liulizhi1031/MyKeyBoardMini/README.md

# **My KeyBoard (Mini)**

呃，这个键盘可能没那么好用。。。

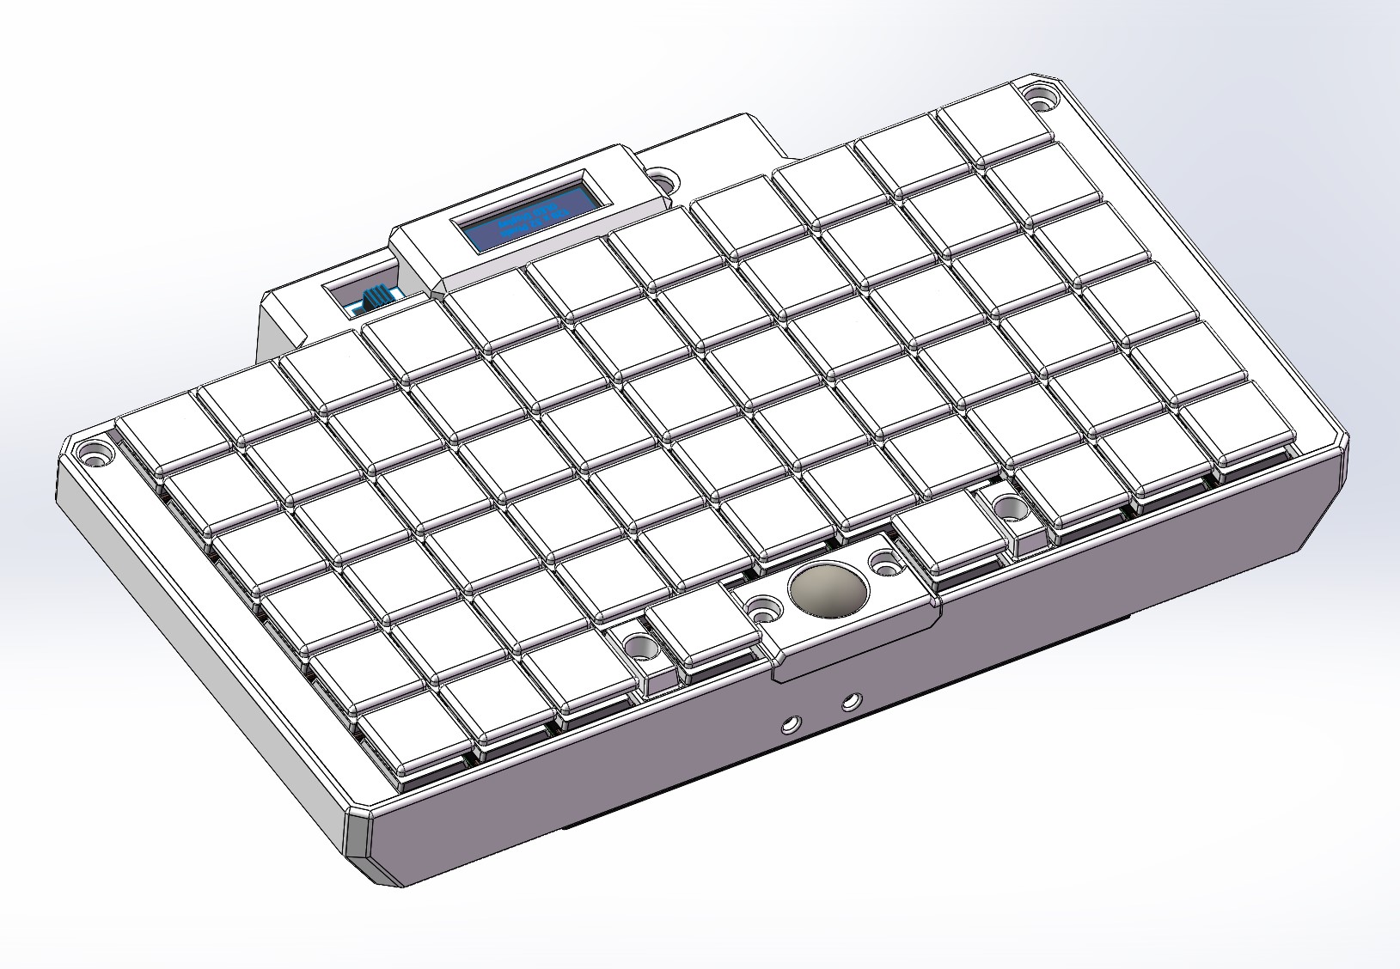
[picture p1: doc/img/3dmodel1.jpg]
3dmodel1


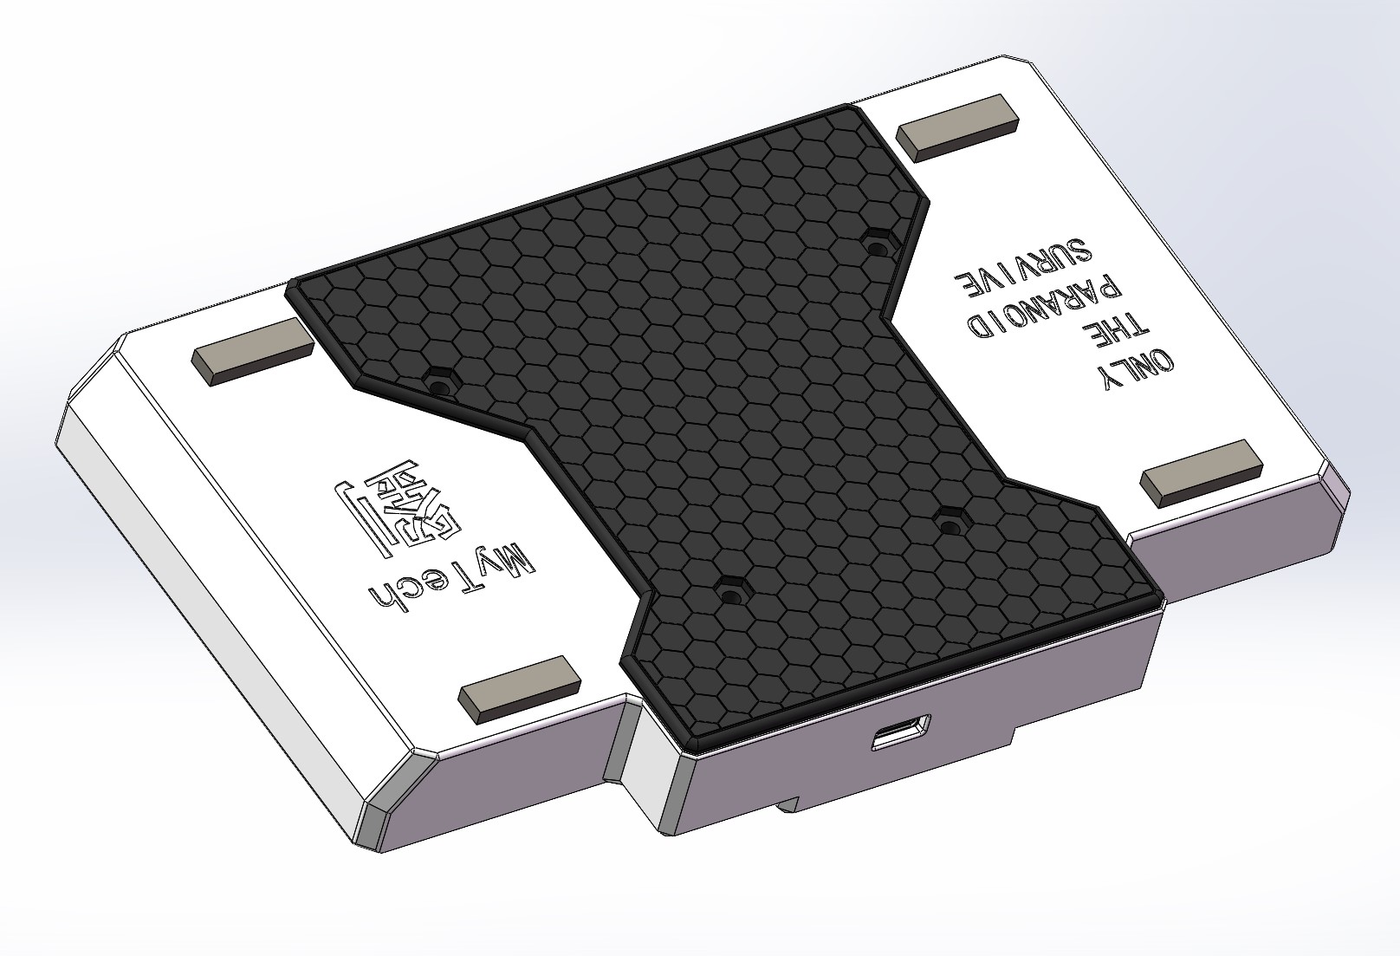
[picture p2: doc/img/3dmodel2.jpg]
3dmodel1
