liulizhi1031/MyKeyBoardMini/doc/doc_design/KeyMapDesign.xlsx

Esc | / ? | ; : | " | [ { | ] } | \ | | - _ | = + | Delete | BackSpace
` ~ | 1 ! | 2 @ | 3 # | 4 $ | 5 % | 6 ^ | 7 & | 8 * | 9 ( | 0 )
Tap | Q (F1) | W (F2) | E (F3) | R (F4) | T (F5) | Y (F6) | U (F7) | I (F8) | O (F9) | P (F10)
CapsLock | A (F11) | S (F12) | D | F | G | H | J | K | L | Enter
Shift | Z | X | C | V | B | N | M (Win) | , < | . > | Shift
Ctrl | Alt | Space |  | ML |  | MR |  | Fn | Alt | Ctrl
