liulizhi1031/MyKeyBoardMini/3dModel/header-2-54/Header Pins/header.SLDASM

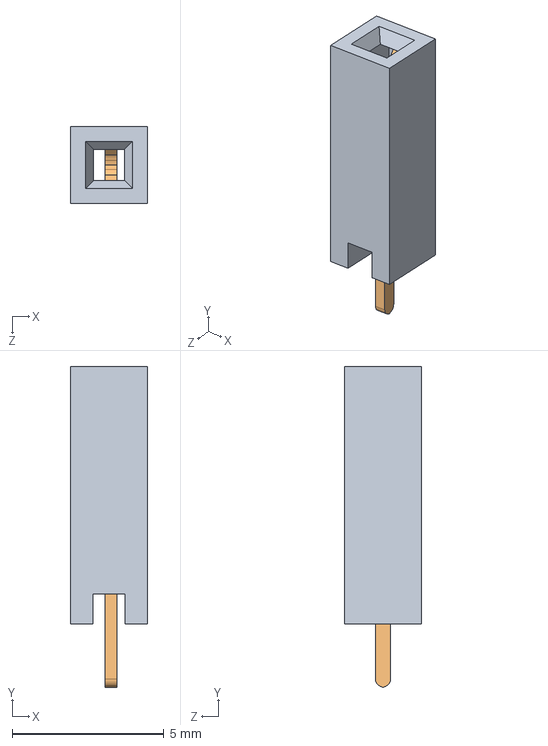
[picture p3: CAD file, 2023-10-30]
3dModel/header-2-54/Header Pins/header.SLDASM
2.54 x 10.6 x 2.54 mm
header
pin
