liulizhi1031/MyKeyBoardMini/3dModel/header-2-54/Header Pins/Header_4.SLDASM

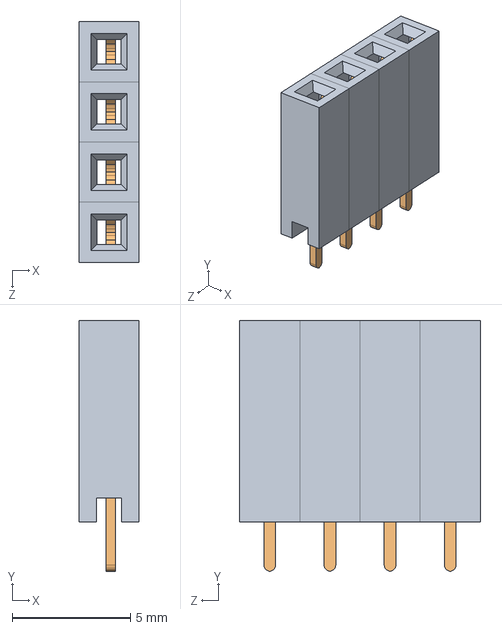
[picture p4: CAD file, 2023-10-30]
3dModel/header-2-54/Header Pins/Header_4.SLDASM
2.54 x 10.6 x 10.2 mm
header x 4
pin x 4
