liulizhi1031/MyKeyBoardMini/3dModel/KEYBOARD.SLDASM

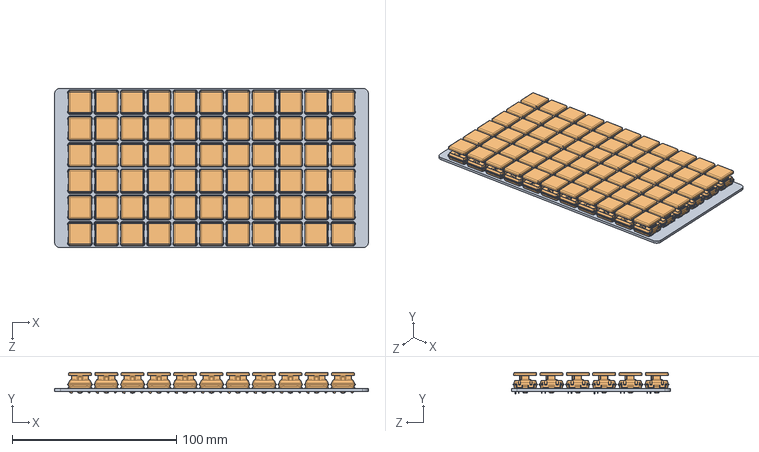
[picture p5: CAD file, 2023-06-11]
3dModel/KEYBOARD.SLDASM
191.0 x 13.0 x 97.0 mm
keyboardbase
KailhLowProfileSwitch x 66
