liulizhi1031/MyKeyBoardMini/3dModel/KAILH_1350/Kailh1350.SLDPRT

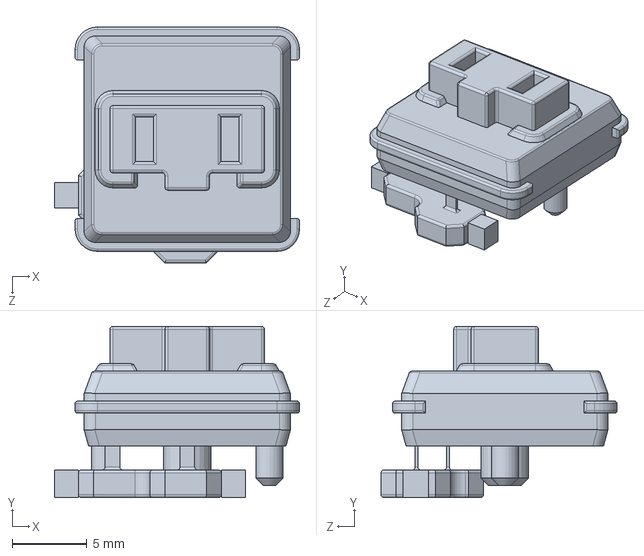
[picture p6: CAD file, 2023-10-30]
3dModel/KAILH_1350/Kailh1350.SLDPRT
16.4 x 11.5 x 15.8 mm
