liulizhi1031/MyKeyBoardMini/3dModel/底盖.SLDPRT

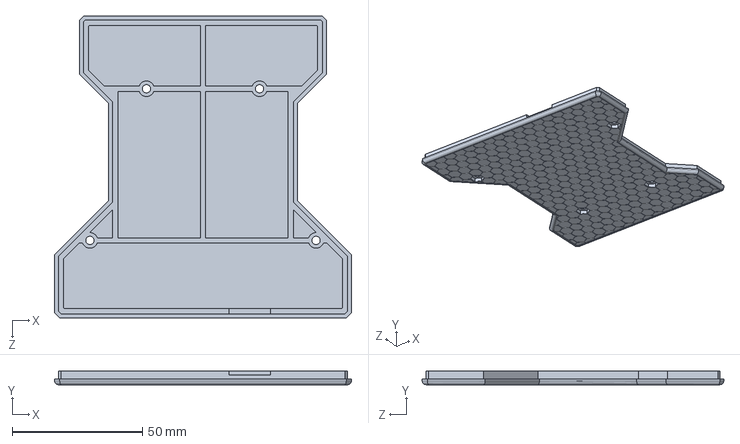
[picture p7: CAD file, 2023-11-14]
3dModel/底盖.SLDPRT
114.0 x 5.20 x 115.8 mm
