liulizhi1031/MyKeyBoardMini/3dModel/header-2-54/Header Pins/pin.sldprt

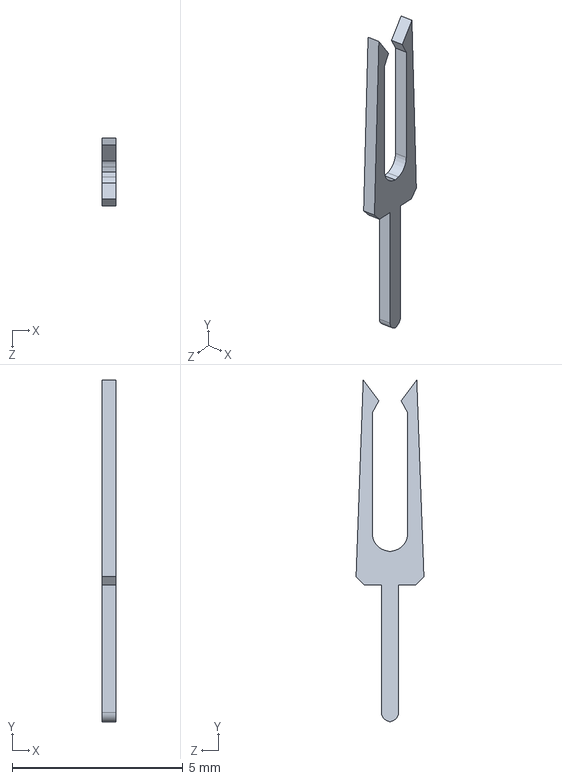
[picture p8: CAD file, 2023-10-30]
3dModel/header-2-54/Header Pins/pin.sldprt
0.4 x 10.0 x 1.99 mm
