liulizhi1031/MyKeyBoardMini/3dModel/轨迹球盖.SLDPRT

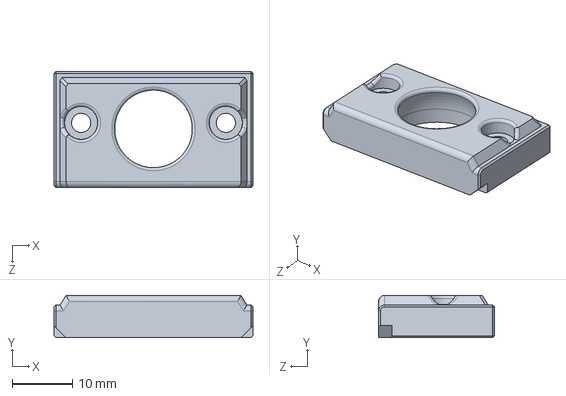
[picture p9: CAD file, 2023-11-14]
3dModel/轨迹球盖.SLDPRT
33.0 x 7.00 x 19.2 mm
