liulizhi1031/MyKeyBoardMini/3dModel/右键盘盖.SLDPRT

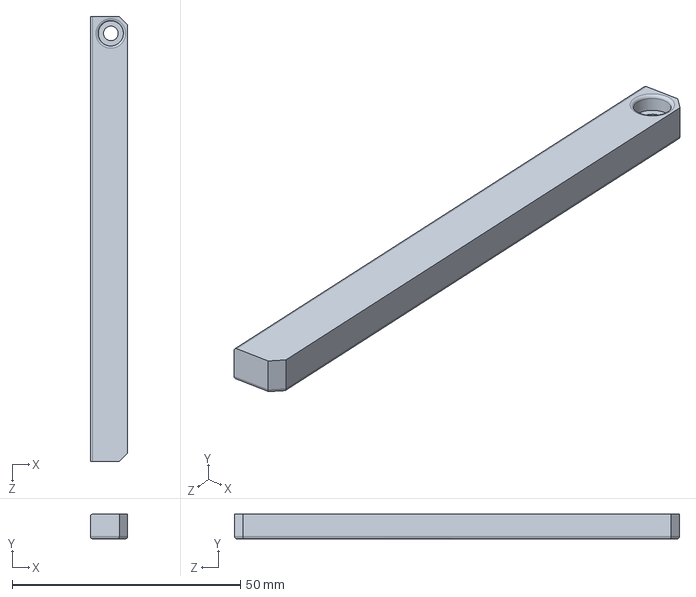
[picture p10: CAD file, 2023-11-14]
3dModel/右键盘盖.SLDPRT
8.20 x 5.40 x 97.4 mm
