liulizhi1031/MyKeyBoardMini/3dModel/TrackBall.SLDPRT

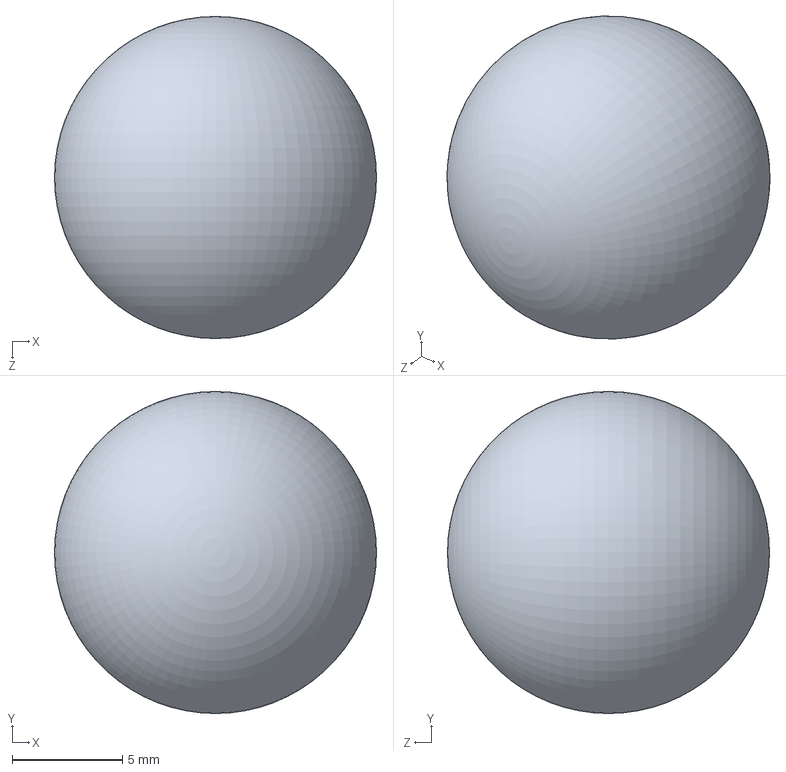
[picture p11: CAD file, 2023-11-14]
3dModel/TrackBall.SLDPRT
14.6 x 14.6 x 14.6 mm
