liulizhi1031/MyKeyBoardMini/3dModel/主壳.SLDPRT

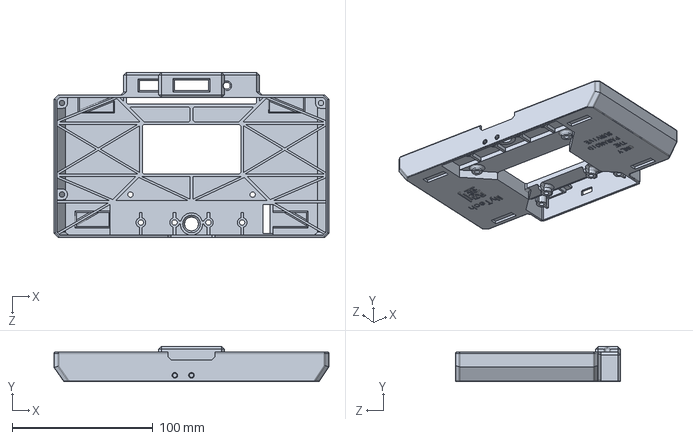
[picture p12: CAD file, 2023-11-14]
3dModel/主壳.SLDPRT
195.4 x 25.0 x 117.4 mm
