liulizhi1031/MyKeyBoardMini/3dModel/KeyCap.SLDPRT

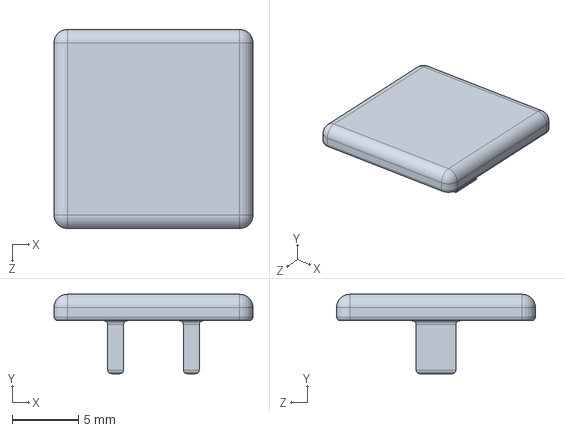
[picture p13: CAD file, 2023-11-14]
3dModel/KeyCap.SLDPRT
15.0 x 6.00 x 15.0 mm
