liulizhi1031/MyKeyBoardMini/3dModel/假键帽.SLDPRT

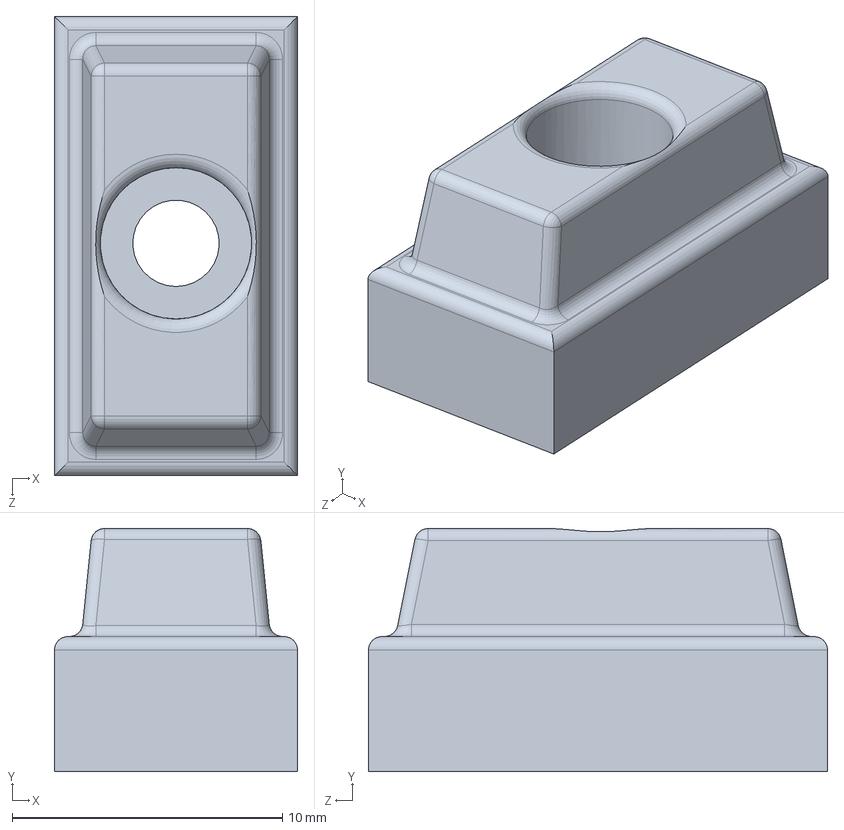
[picture p14: CAD file, 2023-11-14]
3dModel/假键帽.SLDPRT
9.00 x 9.00 x 17.0 mm
