liulizhi1031/MyKeyBoardMini/3dModel/脚垫.SLDPRT

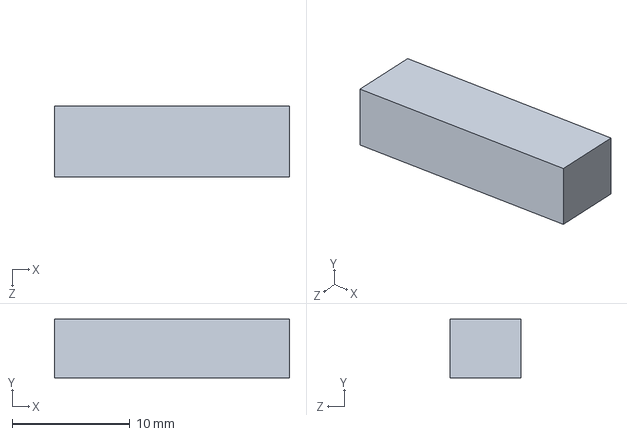
[picture p15: CAD file, 2023-11-13]
3dModel/脚垫.SLDPRT
20.0 x 5.00 x 6.00 mm
