liulizhi1031/MyKeyBoardMini/3dModel/OLED096.SLDPRT

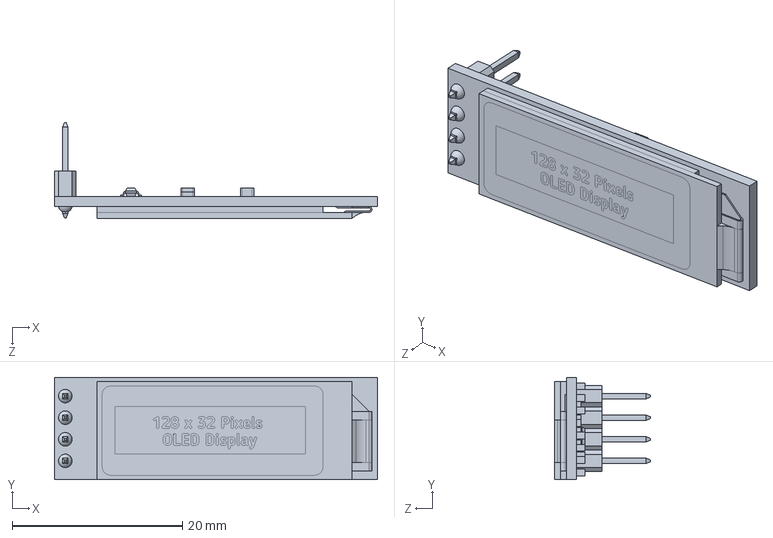
[picture p16: CAD file, 2023-11-11]
3dModel/OLED096.SLDPRT
38.0 x 12.0 x 11.3 mm
