liulizhi1031/MyKeyBoardMini/3dModel/KeyboardModule.SLDPRT

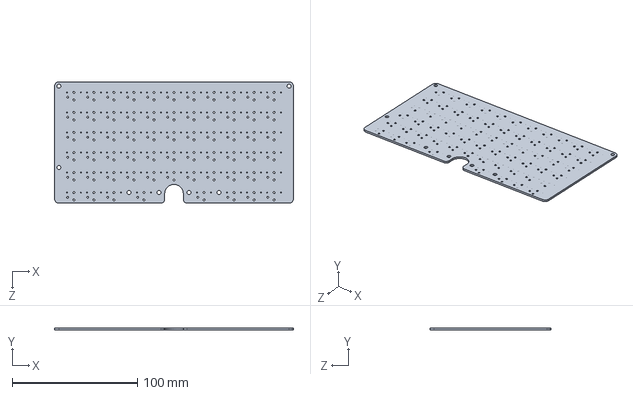
[picture p17: CAD file, 2023-10-30]
3dModel/KeyboardModule.SLDPRT
191.0 x 1.60 x 97.0 mm
