liulizhi1031/MyKeyBoardMini/(list of files, cad)

Other CAD files:
3dModel/左键盘盖.SLDPRT
3dModel/STL/KeyCap.STL
3dModel/STL/TrackBall.STL
3dModel/STL/主壳.STL
3dModel/STL/假键帽.STL
3dModel/STL/右键盘盖.STL
3dModel/STL/左键盘盖.STL
3dModel/STL/底盖.STL
3dModel/STL/轨迹球盖.STL
3dModel/header-2-54/Header Pins/header.SLDPRT
