liulizhi1031/MyKeyBoardMini/pcb_KeyboardControl/KeyboardControl.pdf

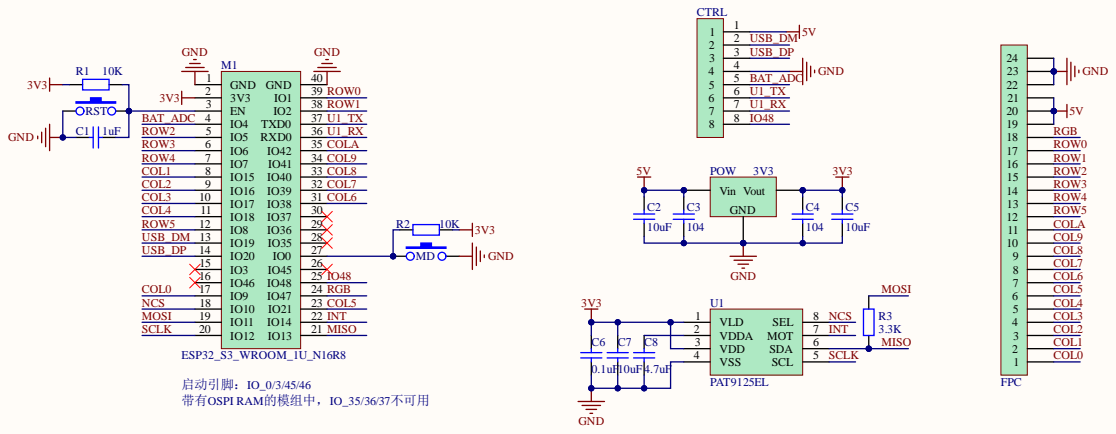
[picture p20: page 1]

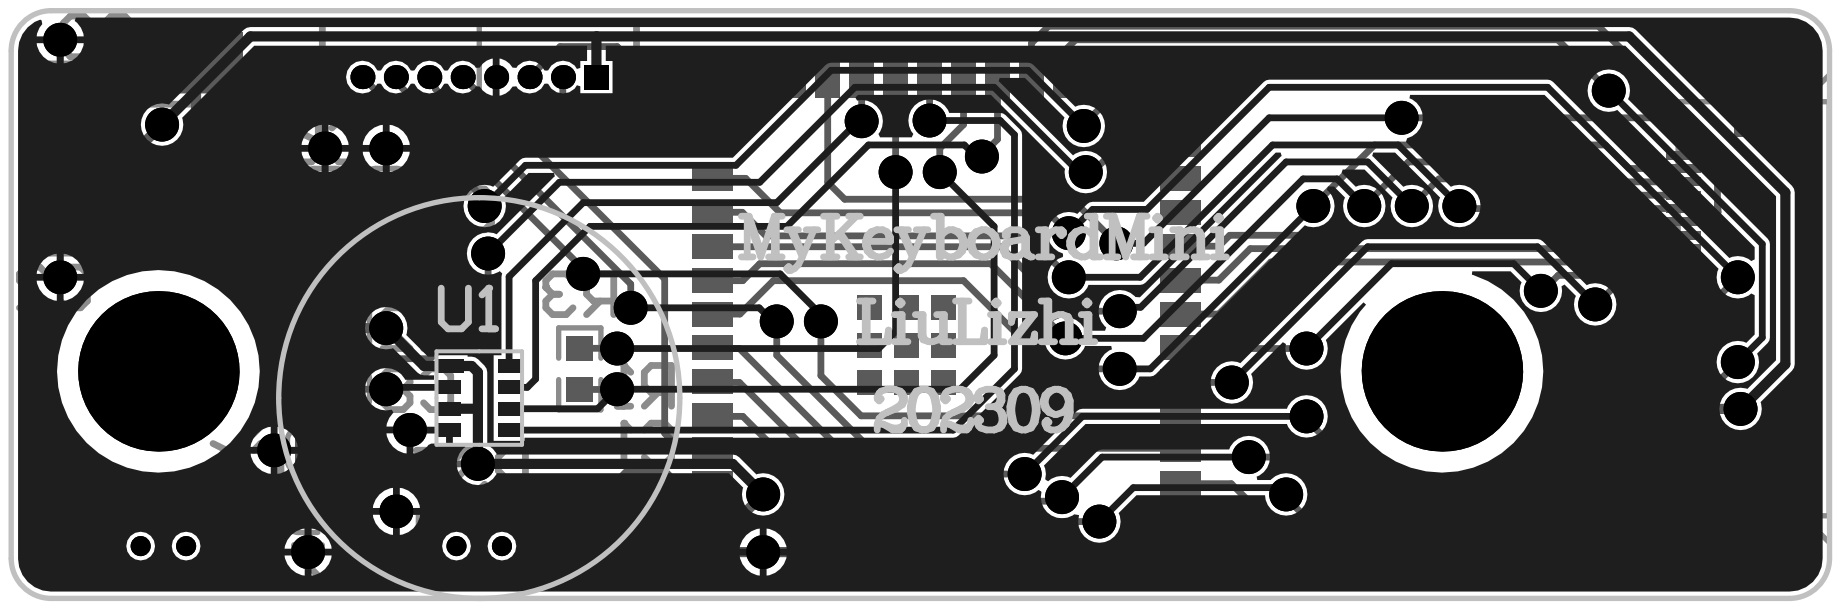
[picture p21: page 2]

Comment | Description | Designator | Footprint | LibRef | Quantity
1uF | 贴片电容 0603 | C1 | 0603 | CAP_0603 | 1
10uF | 贴片电容 0603 | C2, C5, C7 | 0603 | CAP_0603 | 3
104 | 贴片电容 0603 | C3, C4 | 0603 | CAP_0603 | 2
0.1uF | 贴片电容 0603 | C6 | 0603 | CAP_0603 | 1
4.7uF | 贴片电容 0603 | C8 | 0603 | CAP_0603 | 1
SH1.25mm_8P | SH | CTRL | SH1.25MM_8P | SH1.25mm_8P | 1
FPC_0.5_24P | FPC 0.5 24Pin | FPC | FPC_0.5_24PIN | FPC_0.5_24P | 1
ESP32_S3_WROOM_ 1U_N16R8 | ESP32 S3模组 | M1 | ESP32_S3_WROOM_ 1U | ESP32_S3_WROOM_ 1U | 1
KEY | 卧式贴片按键 2*4*3.5mm | MD, RST | KEY_SMT_4_L | KEY_SMT_4_L | 2
3V3 | 线性稳压器 | POW | SOT223 | LDO_AMS1117 | 1
10K | 电阻 0603 | R1, R2 | R_0603 | RES_0603 | 2
3.3K | 电阻 0603 | R3 | R_0603 | RES_0603 | 1
PAT9125EL | Optical Tracking Miniature Chip | U1 | PAT9125EL | PAT9125EL | 1
