liulizhi1031/MyKeyBoardMini/pcb_KeyboardMoudle/KeyboardMoudle.pdf

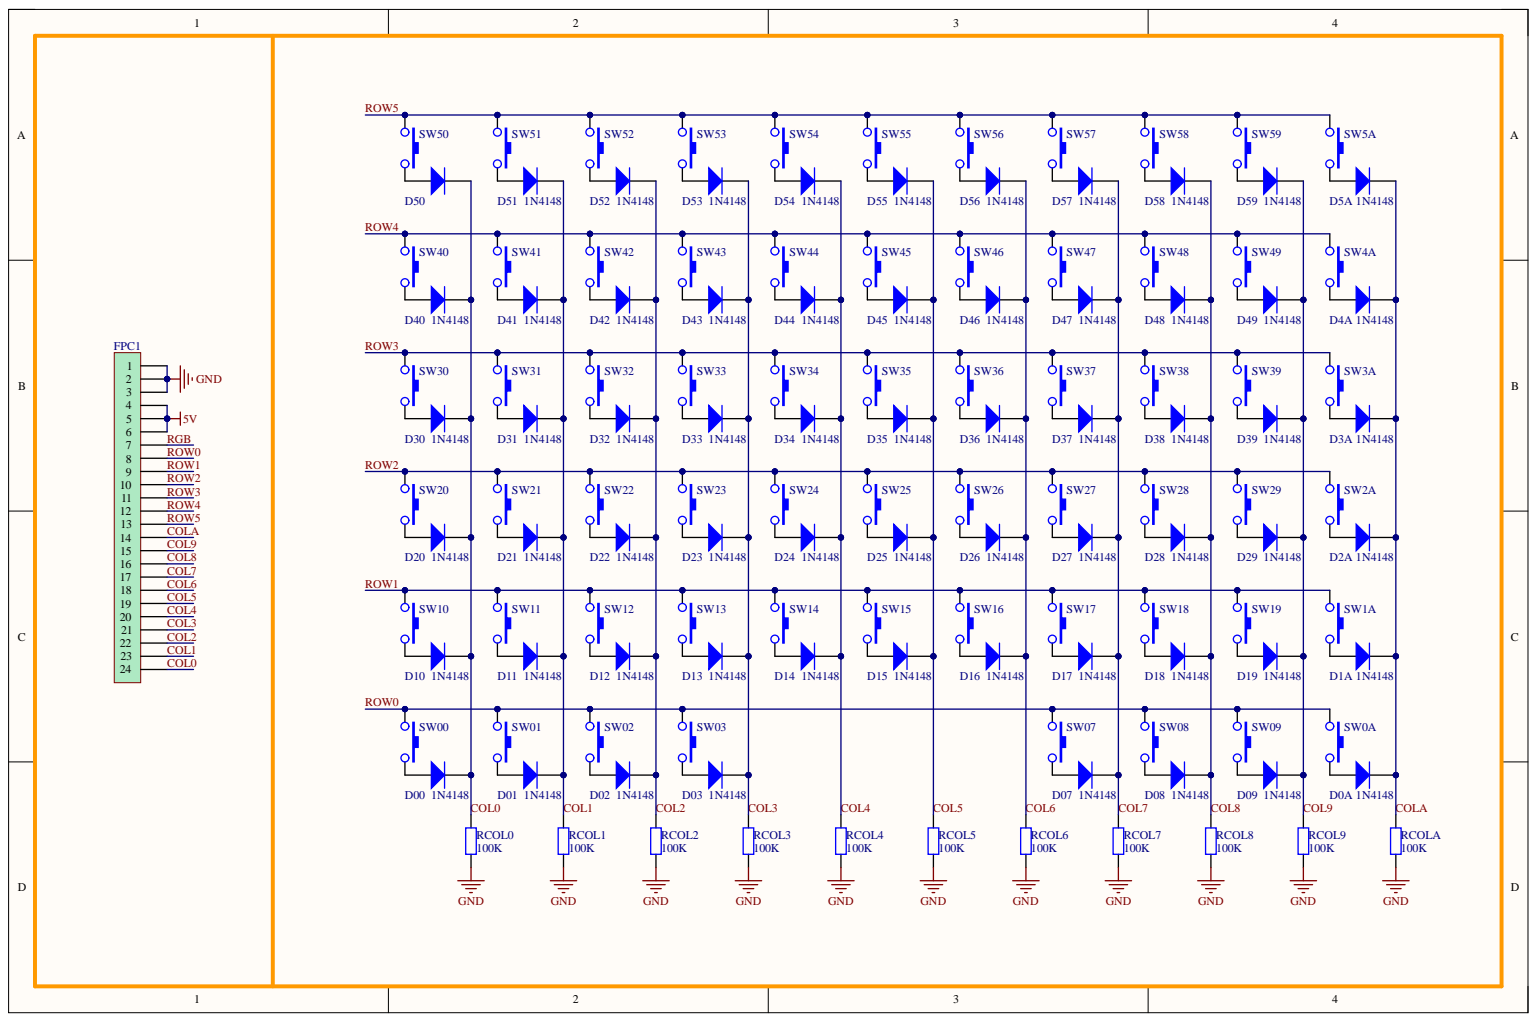
[picture p22: page 1]

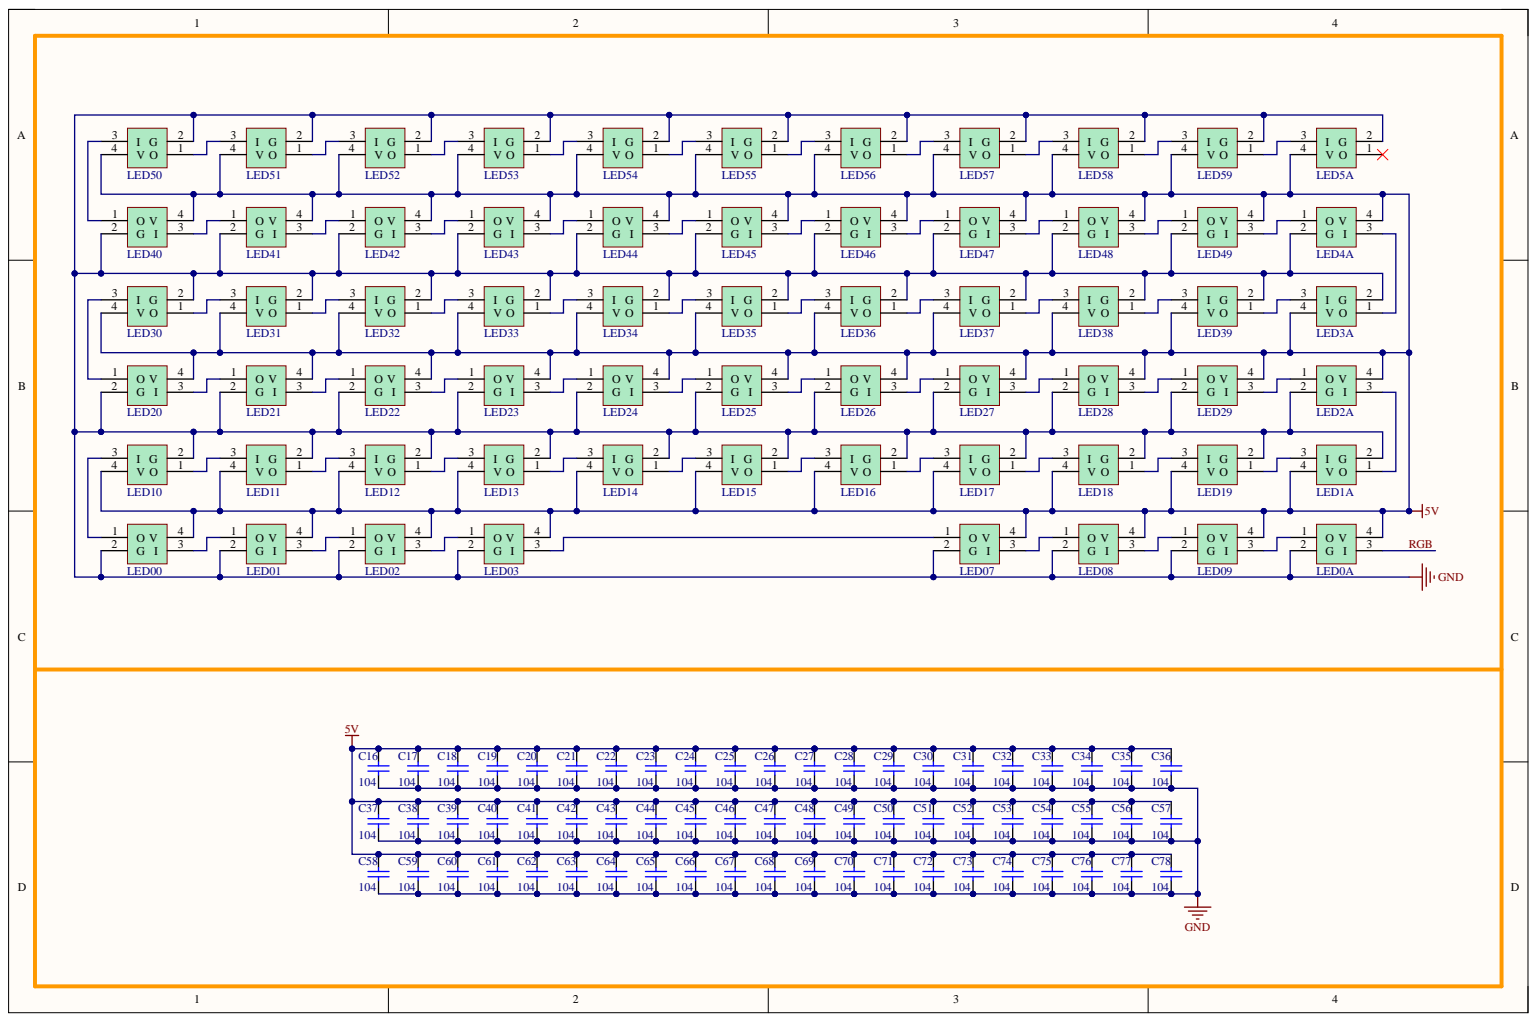
[picture p23: page 2]

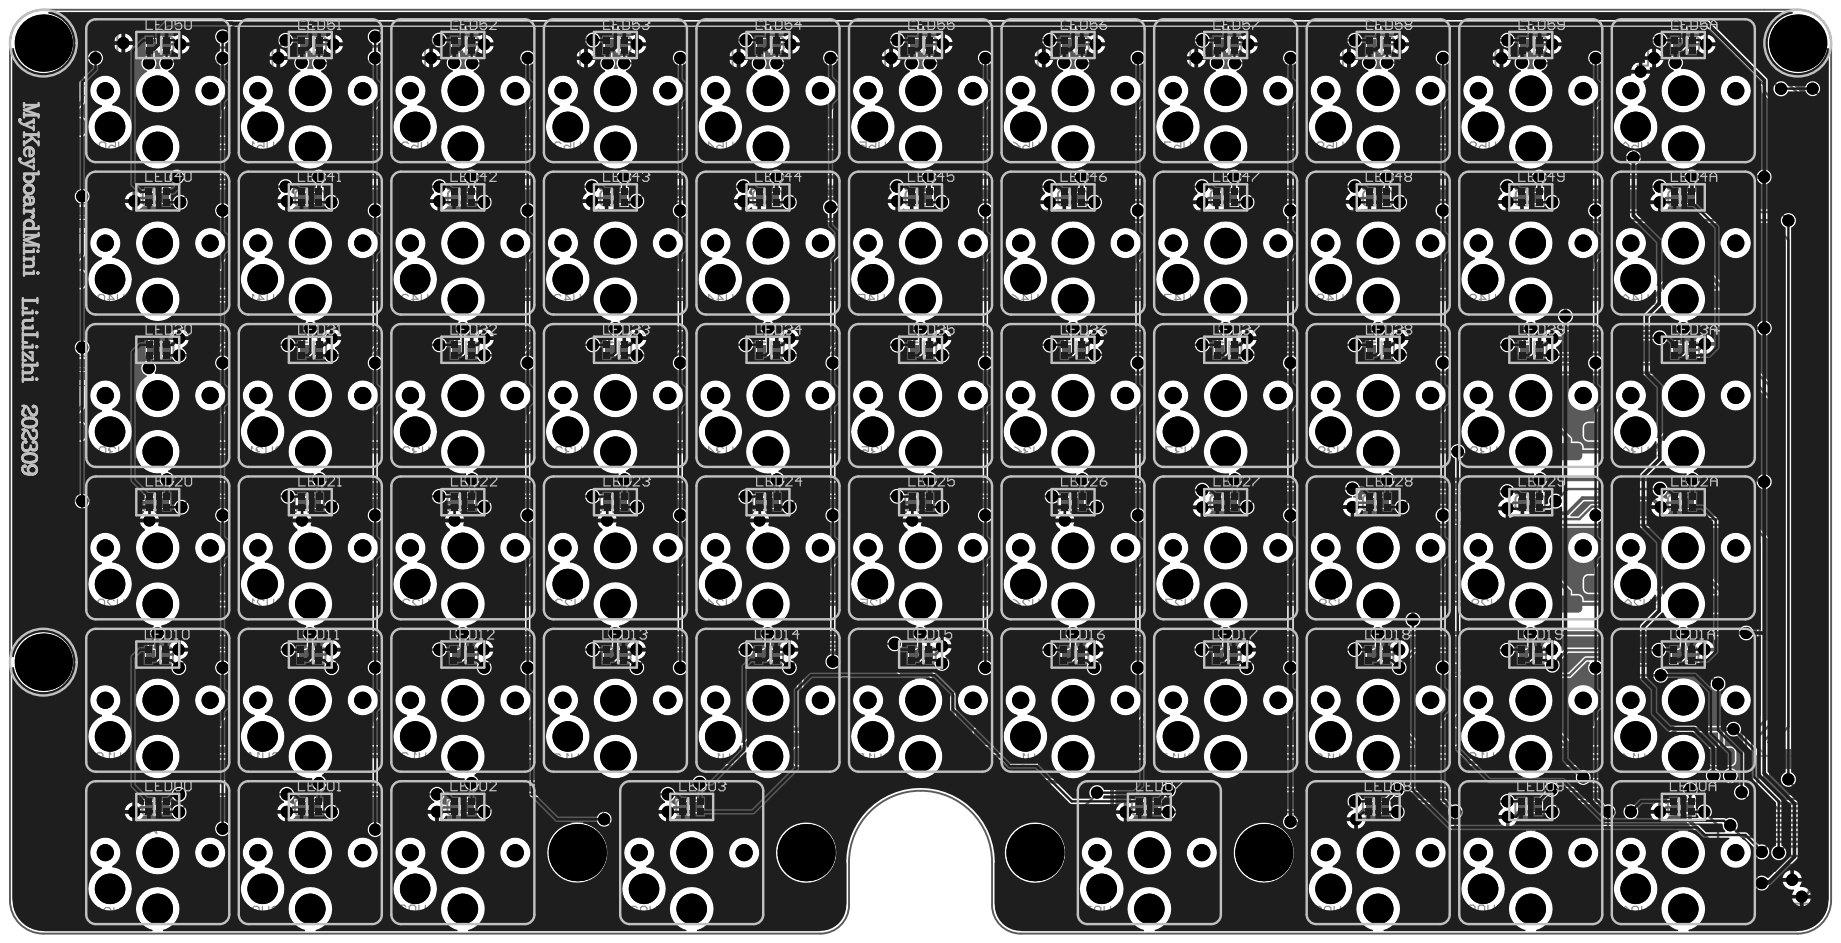
[picture p24: page 3]

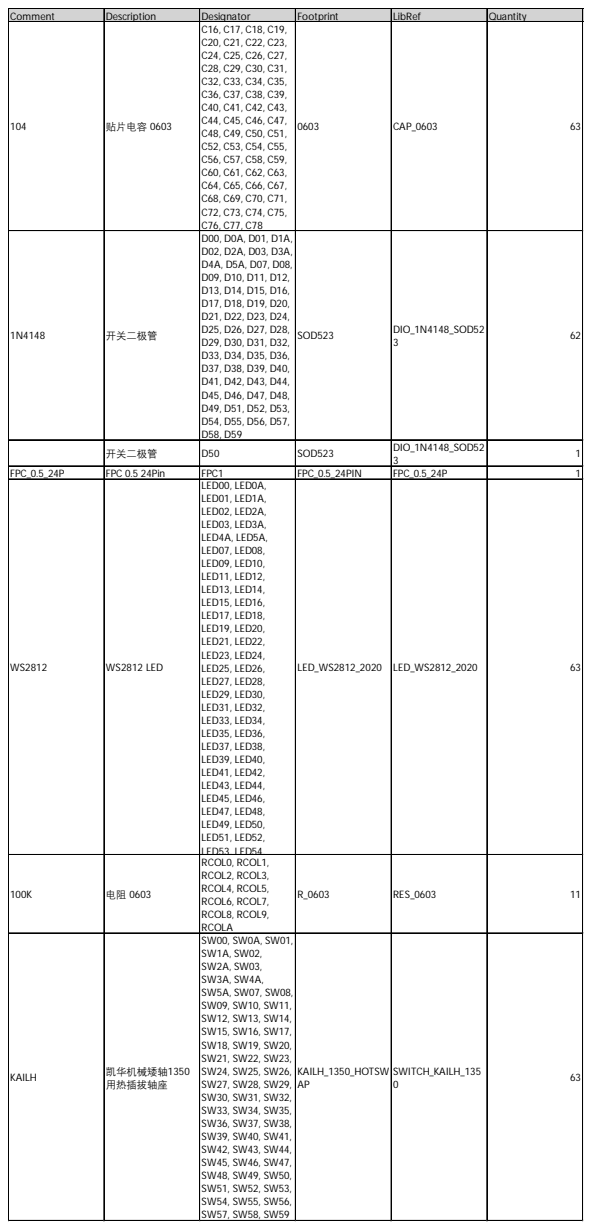
[picture p25: page 4]

Comment | Description | Designator | Footprint | LibRef | Quantity
104 | 贴片电容 0603 | C16, C17, C18, C19, C20, C21, C22, C23, C24, C25, C26, C27, C28, C29, C30, C31, C32, C33, C34, C35, C36, C37, C38, C39, C40, C41, C42, C43, C44, C45, C46, C47, C48, C49, C50, C51, C52, C53, C54, C55, C56, C57, C58, C59, C60, C61, C62, C63, C64, C65, C66, C67, C68, C69, C70, C71, C72, C73, C74, C75, C76, C77, C78 | 0603 | CAP_0603 | 63

1N4148 | 开关二极管 | D00, D0A, D01, D1A, D02, D2A, D03, D3A, D4A, D5A, D07, D08, D09, D10, D11, D12, D13, D14, D15, D16, D17, D18, D19, D20, D21, D22, D23, D24, D25, D26, D27, D28, D29, D30, D31, D32, D33, D34, D35, D36, D37, D38, D39, D40, D41, D42, D43, D44, D45, D46, D47, D48, D49, D51, D52, D53, D54, D55, D56, D57, D58, D59 | SOD523 | DIO_1N4148_SOD52 3 | 62

开关二极管 | D50 | SOD523 | DIO_1N4148_SOD52 3 | 1

FPC_0.5_24P | FPC 0.5 24Pin | FPC1 | FPC_0.5_24PIN | FPC_0.5_24P | 1
WS2812 | WS2812 LED | LED00, LED0A, LED01, LED1A, LED02, LED2A, LED03, LED3A, LED4A, LED5A, LED07, LED08, LED09, LED10, LED11, LED12, LED13, LED14, LED15, LED16, LED17, LED18, LED19, LED20, LED21, LED22, LED23, LED24, LED25, LED26, LED27, LED28, LED29, LED30, LED31, LED32, LED33, LED34, LED35, LED36, LED37, LED38, LED39, LED40, LED41, LED42, LED43, LED44, LED45, LED46, LED47, LED48, LED49, LED50, LED51, LED52, LED53, LED54, | LED_WS2812_2020 | LED_WS2812_2020 | 63

100K | 电阻 0603 | RCOL0, RCOL1, RCOL2, RCOL3, RCOL4, RCOL5, RCOL6, RCOL7, RCOL8, RCOL9, RCOLA | R_0603 | RES_0603 | 11

KAILH | 凯华机械矮轴1350 用热插拔轴座 | SW00, SW0A, SW01, SW1A, SW02, SW2A, SW03, SW3A, SW4A, SW5A, SW07, SW08, SW09, SW10, SW11, SW12, SW13, SW14, SW15, SW16, SW17, SW18, SW19, SW20, SW21, SW22, SW23, SW24, SW25, SW26, SW27, SW28, SW29, SW30, SW31, SW32, SW33, SW34, SW35, SW36, SW37, SW38, SW39, SW40, SW41, SW42, SW43, SW44, SW45, SW46, SW47, SW48, SW49, SW50, SW51, SW52, SW53, SW54, SW55, SW56, SW57, SW58, SW59 | KAILH_1350_HOTSW AP | SWITCH_KAILH_135 0 | 63
