liulizhi1031/MyKeyBoardMini/(list of files, drawings)

Other design files:
pcb_KeyboardControl/KeyboardControl.PcbDoc
pcb_KeyboardControl/KeyboardControl.PrjPcb
pcb_KeyboardControl/KeyboardControl.SchDoc
pcb_KeyboardMoudle/KeyboardMoudle1.SchDoc
pcb_KeyboardMoudle/KeyboardMoudle2.SchDoc
pcb_KeyboardMoudle/KeyboardMoudle.PrjPCB
pcb_KeyBoardPower/KeyBoardPower.PcbDoc
pcb_KeyBoardPower/KeyBoardPower.PrjPcb
pcb_KeyBoardPower/KeyBoardPower.SchDoc
