liulizhi1031/MyKeyBoardMini/(commit log)

2023-06-14 refactor: design update
    design update
    [KeyboardMoudle.PcbDoc, KeyboardMoudle.PrjPCB]
2023-09-12 design: pcb design
    pcb design
    [KeyMapDesign.xlsx, KeyboardMoudle.PcbDoc, KeyboardMoudle.PrjPCB, KeyboardMoudle1.SchDoc, KeyboardMoudle2.SchDoc, KeyboardMoudle3.SchDoc, PG1350-socket.STEP, TrackBall.SLDPRT]
2023-09-21 design: pcb design update
    pcb design update
    [KeyboardControl.PcbDoc, KeyboardControl.PrjPcb, KeyboardControl.SchDoc, KeyboardMoudle1.SchDoc, TrackBalloptics.PcbDoc, TrackBalloptics.PrjPcb, TrackBalloptics.SchDoc]
2023-10-07 design: pcb and 3d model update
    pcb and 3d model update
    [KailhLowProfileSwitch.SLDPRT, KeyboardControl.PcbDoc, KeyboardControl.PrjPcb, KeyboardMoudle.PrjPCB, PG1350-socket.STEP]
2023-10-24 design: PowerModule pcb update
    PowerModule pcb update
    [KeyBoardPower.PcbDoc, KeyBoardPower.SchDoc]
2023-10-30 design: 3d model update
    3d model update
    [Header_4.SLDASM, Kailh1350.SLDPRT, KailhLowProfileSwitch.SLDPRT, KeyCap.SLDPRT, KeyboardModule.SLDPRT, header.SLDASM, header.SLDPRT, pin.sldprt]
2023-11-04 design: 外壳设计更新
    外壳设计更新
    [Header_4.SLDASM, 主壳.SLDPRT]
2023-11-13 design: 完成主壳设计
    1.完成主壳设计
    [主壳.SLDPRT, 底盖.SLDPRT, 脚垫.SLDPRT]
2023-11-14 design: 外壳设计基本完成
    外壳设计基本完成
    [KeyCap.SLDPRT, KeyCap.STL, TrackBall.SLDPRT, TrackBall.STL, 主壳.SLDPRT, 主壳.STL, 假键帽.SLDPRT, 假键帽.STL]
